Barneylyw/Bike-Aux/README.md

# Bike Auxiliary System

To power a buzzer, head lights, and tail lights with one (or more) rechargeable Li-ion battery.
 
<p align="center">bike aux</p>
Diagram 1: Rough image visualization of how the system will behave
Where the buzzer will act as a bell which will be activated by a button. The head lights and tail lights will be activated with one switch.

--Overall design Considerations--
- as small as possible
- minimize the number of re-order PCBs due to non-design related issues
- ICs should be as cheap as possible

(All blue texts are links to component datasheet)

## Project Status

| Board | Designed | Ordered | Soldered | Tested | Working | Notes |
|---|:---:|:---:|:---:|:---:|:---:|---|
| Buzzer Board | ✅ | ✅ | ✅ | ✅ | ✅ | Fully working |
| Power Dist. Board  | ✅ | ✅ | 🟡 | 🟡 | 🟡 | Oscillator unsoldered, see issues |
| Charger Board | ✅ | ✅ | ⬜ | ⬜ | ⬜ | |
| Headlight Board | ✅ | ✅ | ✅ | ✅ | ⬜ | |
| Taillight Board | ✅ | ✅ | ✅ | ✅ | ✅ | |

Legend: ✅ done · 🟡 in progress / partial · ⬜ not started

## Known Issues

| # | Board | Symptom | Hypothesis | Potential Solution |
|---|---|---|---|---|
| 1 | PDB | Vout = 2·Vin instead of 5V | Used 680µF cap instead of 680nF | uhhh, change the cap? |
| 2 | PDB (LED2000)  | LED+/LED- and all GND read ~4.6–4.7V | AGND/PWR GND isolated from circuit GND | connect AGND&PGND to ckt gnd via resistors |
| 3 | PDB (BMS) | Current doesn't drop to 0 below 2.8V UVP | Unknown — needs further probing | no clue |
| 4 | PDB (osc.) | Pin layout on SIT1534 guessed, unverified | Footprint from Ultra Librarian lacked pinout  | use a 555 timer (apperently they are not dead, there is a CMOS version) | 

### Buzzer Sub-system

Problem: My standard bike bell cannot be rung with gloves in the winter
Solution: Make a 'bell' that can be activated with a button

Buzzer used: [AI-3035-TWT-3V-R](https://puiaudio.com/file/specs-AI-3035-TWT-3V-R.pdf)
- resonance frequency (3500+-500Hz) and sound pressure level (100dB at 10cm) is similar to that of a typical bike bell
- continuous tone, more control from the user
- through hole, easier to test and solder

To achieve the desired 4000Hz, [LTC6990](https://www.analog.com/media/en/technical-documentation/data-sheets/ltc6990.pdf) is used to set the output frequency (div code = 7). The [LTC6990 online tool](https://beta-tools.analog.com/timerblox/LTC6990#) is used to help determine the value of resistance needed to set the frequency to 4kHz

The plan: First simulate the design in LTspice to ensure the resistance setting will achieve 4kHz, then design the PCB board with Altium Designer

<p align="center">6990 simulated</p>

Image 1: LTC6990 being simulated in LTspice, with the output frequency of 4kHz at a 3V output when the input is a 3VDC supply

After confirming the design will achieve 4kHz output, I used Altium Designer to design the schematic layout, then designed the PCB layout for the board

<p align="center">Buzzer Board schematic</p>

Image 2: Buzzer board schematic with the resistance value simulated in LTspice and 3V3 input and output both with B2B-XH-A 2-pin headers

<p align="center">Buzzer Board</p>

Image 3: Buzzer board PCB layout viewed from top layer with components from schematic and I/O ports labeled

--Specific Design Considerations--
- N/A

### Headlight

Headlight requirements:
- White
- greater than 600lm (similar to an off-the-sheleve part)
- <3A current to avoid overheating
According to the datasheet, [XMLBWT-00-0000-0000U3051](https://downloads.cree-led.com/files/ds/x/XLamp-XML2.pdf) (P.4) can achieve 628 lumens at 1.5A and 798 lumens at 2A (XMLBWT-00-0000-0000U4051 is brighter, but it is only sold in 1000s on Digi-Key)
Therefore, XMLBWT-00-0000-0000U3051 is chosen to be the headlights
#### Headlight Board
--Specific Design Considerations--
- heat dissipation via vias on the GND pad of the LED
- aluminum PCB to maximize heat dissipation (as I am writing this, I realized I don't need heat dissipation vias as aluminum PCBs only have 1 layer, but I already ordered it)
- GND plated through holes so that it can be connected to the bike frame
- power port
<p align="center">Front LED board</p>
Image 4: Headlight board layout with design considerations in mind

### Taillight

Taillight requirements:
- Red
- 100lm (similar to an off-the-sheleve part)

I chose [JE2835AHR-N-0001A0000-N0000001](https://downloads.cree-led.com/files/ds/j/JSeries-2835-Color.pdf), thinking it was a red light with 130lm, but I didn't notice it refers to radiant flux instead of luminous flux.
This might not work as intended with my current setup.
#### Taillight Board
--Specific Design Considerations--
- power port
- mounting holes
<p align="center">Rear LED board</p>
Image 5: Taillight board layout with a power port and mounting holes

### BMS (used in both Power Distribution Board and Charger Board)
BMS requirements:
- OVP: 4.2V
- UVP: 2.8V

[BQ297xx](https://www.ti.com/lit/ds/symlink/bq2972.pdf) family is chosen for its small BOM size and low shutdown current, I chose BQ29737 because it is the closest one that matches my requirements
following their design procedure with max load discharge current = 5A (headroom from 4A) 20mΩ is needed across both FET and V_gs=3.5, so CSD16406Q3 is likely going to work as the charging and discharging FETs

following the Typical Application from the datasheet, I created the schematic for BMS

Image 6: schematic of BMS system with BQ29737DSER as the BMS IC and CSD16406Q3 as the external charging and discharging FETs as the typical application have instructed

### Power Distribution Board
This might be the most complex system in this project... many things can (and probably will) go wrong here...
<p align="center">PDB</p>
Image 7: rough visualization of what the power distribution board consists of, blue arrows indicates power input/output ports

#### Voltage Regulator
Thr original idea is to use an LDO as it is the simplist, but since the li-ion battery doesn't have constant voltage, it can only regulate when the V_batt is high enough, so I decided to use a switching regulator

Voltage regulator requirement:
- be able to supply 5V with 4A max
I input my requirements into TI's Webench tool and it returned TPS61089 with this configuration is able to reach 5V 4A max
<p align="center">TPS61089RNRR 5V4A</p>
Image 8: how TPS61089 should be configured according to Webench

I then copied it to my schematic document in Altium
<p align="center">VR in Altium
</p>
image 9: my schematic of TPS61089 without some of the input capacitors

#### Front LED (Headlight) driver
Front LED driver requirements:
- be able to supply 2A, 3.5V(V_fled)
- easy to use
[LED2000](https://www.st.com/content/ccc/resource/technical/document/datasheet/0f/92/f3/d6/fb/2e/49/ef/DM00060040.pdf/files/DM00060040.pdf/jcr:content/translations/en.DM000600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) is able to supply 2A and 3.5V with this configuration according ST's eDesignSuite, so I copied it to my schematic document in Altium
<p align="center">Front driver config according to ST</p>
Image 10: how LED2000 should be configured according to eDesignSuite
<p align="center">Front driver in Altium</p>
image 11: my schematic of LED2000

#### 1 Hz oscillator
The original plan was to either use a 555timer or dividing a crystal signal, but then i found the [SIT1534AC-J5-DCC-00.001E](https://www.digikey.ca/en/products/detail/sitime/SIT1534AC-J5-DCC-00-001E/7793956) can produce a 1 Hz signal, so I opted for the easy solution as this is not the focus of this project and I don't need the timer to be 100% accurate, just ~1 Hz

The footprint I downloaded from Ultra Librarian doesn't specificify which pin is which while the symbol does, so I guessed the layout, so it might not work as intended(i.e. the taillight won't blink)

I have since realized that it is a crystal oscillator, which is an absolute overkill. I might go for the 555timer solution since I still don't know what the pin layout is

#### Rear LED (taillight) driver
Rear LED driver requirements:
- able to supply >250mA
- consist of an enable pin
- 5V input
- easy to use

I was debating between [NCP3066](https://mm.digikey.com/Volume0/opasdata/d220001/medias/docus/1149/NCP%2CNCV3066.pdf) and [Pam2804](https://www.diodes.com/assets/Datasheets/PAM2804.pdf)
<table>
  <tr>
    <th></th>
    <th>NCP3066</th>
    <th>PAM2804</th>
  </tr>
  <tr>
    <td>Max current supply</td>
    <td>1.5A</td>
    <td>1A</td>
  </tr>
  <tr>
    <td>External parts</td>
    <td>7</td>
    <td>4</td>
  </tr>
  <tr>
    <td>Input voltage</td>
    <td>0-42V</td>
    <td>2.5-6V</td>
  </tr>  
  <tr>
   <td>How to determine components</td>
   <td>9 equations</td>
   <td>I_led = 0.1/Rs</td>
  </tr>
</table>
Table 1: a table I made for myself to compare which one is the better option, both matches the requirements, but PAM2804 is easier to use, therefore PAM2804 is chosen as the rear led driver

To determine Rs, I used the provided equation : I_led = 0.25A = 0.1/Rs -> 0.4Ω and created the schematic accordingly
<p align="center">Rear LED driver in Altium</p>
Image 12: schematic of the rear led driver with R9 = 0.4Ω to set the I_led = 0.25A

#### Board layout
requirements for TPS61089:
- Minimize length and area connected to SW pin
- Capacitors should be as close to their respectful pins as possible
- Vout path should be as short as possible
- Current carrying paths should be wider
requirements for LED2000:
- FB connections be far from high current paths
- FB -> R_sense path be as short as possible
- 2 GND plans connected at Cout (C6 in my schematic)
-  - Signal GND: AGND(Pin6), R3, C7
   - PWR GND: Cout(C6), Cin(C3), GND(Pin7), PWR GND(Pin2)
Personal requirements:
- section by section so that it's easier to separate parts
- test points (at Vin,Vout,CLK_out,I_fled,I_rled)
- raw 3.7V input port for testing
- smaller than 10cm x 5cm

to determine the trace width, I used the [digikey trace width calculator](https://www.digikey.ca/en/resources/conversion-calculators/conversion-calculator-pcb-trace-width) to determine the width at different traces while assuming 10C rise:
<table style="width:100%; border-collapse: collapse; border: 1px solid #ddd;">
  <tr style="background-color: #2196F3; color: white;">
    <th style="border: 1px solid #ddd; padding: 12px;">Input Current (A)</th>
    <th style="border: 1px solid #ddd; padding: 12px;">External Trace Width (mm)</th>
  </tr>
  <tr>
    <td style="border: 1px solid #ddd; padding: 12px;">6</td>
    <td style="border: 1px solid #ddd; padding: 12px;">3.55</td>
  </tr>
  <tr style="background-color: #f9f9f9;">
    <td style="border: 1px solid #ddd; padding: 12px;">4</td>
    <td style="border: 1px solid #ddd; padding: 12px;">2.03</td>
  </tr>
  <tr>
    <td style="border: 1px solid #ddd; padding: 12px;">2</td>
    <td style="border: 1px solid #ddd; padding: 12px;">0.78</td>
  </tr>
  <tr style="background-color: #f9f9f9;">
    <td style="border: 1px solid #ddd; padding: 12px;">0.25</td>
    <td style="border: 1px solid #ddd; padding: 12px;">0.0444</td>
  </tr>
</table>
table 2: how wide should the trace be depending on the current with temperature rise = 10C, only external width matter since I am only designing a 2 layer PCB
<p align="center">PDB</p>
image 13: final design of the PDB with all the design requirements followed as closely as possible. includes 1 input port, 3 output port, 1 test input port, mounting holes, and words to indicate what is what.

Since the LED 2000 requires an AGND and PWG GND, but I don't know how they should be connected to the rest of the grounds, I separated them from circuit ground, which might be a bad design decision...

### Charger Board
Charger board requirements:
- charger IC
- BMS, as backup to stop charging (reuse the same system as before)
- power input port
Charger IC requirements:
- 4.2V cutoff
- simple to use
- >=500mA charge current
- protection agains't charging from cold
- easy to add indicator/built in capabilities for them
[BQ24040](https://www.ti.com/lit/ds/symlink/bq24040.pdf) is the smartest with the most protection out of my options of [Sl4056E](https://mm.digikey.com/Volume0/opasdata/d220001/medias/docus/8922/5399_SL4056E%20ESOP-8.pdf) and [MCP73811](https://ww1.microchip.com/downloads/aemDocuments/documents/OTH/ProductDocuments/DataSheets/22036b.pdf) and it also have `charging`  and `power good` indicators.

I_charge is usually 0.2-0.5C (C = capacity of Li-ion battery)
I_charge = 1A in my case

I used the [BQ24040 Application Report](https://www.ti.com/lit/an/slua901/slua901.pdf?ts=1787425354239) as my guide to 1A fast charge design except with %_IOutFC = 10% = 100mA
following the design procedure outlined:
I_out-FC = 1A
%_I-Out-FC=10%
R_ISet = 540AΩ/1000mA = 540Ω (549Ω is the closest most abundantly available resistor)
R_Pre-term = 200Ω/% * 1-% = 2kΩ

I decided to use the C_out pin from BMS for a `complete charge` indicator alongside a FET and power from Vin

knowing C_out will be pulled to 0.4-0.5V when full charge and V_in = 5V, V_gs = ~-4.5V, V_gs(th) from [Bss84AK](https://assets.nexperia.com/documents/data-sheet/BSS84AK.pdf) is - 1.6V > -4.5V, so it would work in theory. I also recreated the circuit in LTspice to verify that it works.

<p align="center">Charge indicator in LTspice</p>
image 14: full charge indicator verification in LTspice, showing the current leaving R2 = -1mA at 3.4V and -20mA at 0.4V, so it should work

I then put everything into the schematic
<p align="center">Charger schematic</p>
Image 15: charger schematic, showing both BQ24040, BQ29737, BSS84AK, and dual input options, barrel jack and USB micro

<p align="center">Charger layout</p>
Image 16: charger board layout with the LEDs being all over the place 😅

### PCB and parts
They are ordered from JLCPCB, Digikey, and Mouser; what I ordered can be found in the `orders` folder

## Assembly and testing

This section covers how I assemble and test different boards

Note: I am documenting my testing day of (or a few days) after I conducted the tests, so from here on it will be more of a log than anything. I apologize for the causal wording.

### Buzzer Board
I spread the solder paste onto the board and placed the parts where they are supposed to go according to the design, and used hot-air reflow to solder everything in place.

<p align="center">boards out of factory</p>
Image 17: unassembled buzzer boards

<p align="center">assembled buzzer board</p>
Image 18: buzzer board after I soldered the components and pins on it

To test the functionality of the board, I used Analog Discovery 2's (AD2) `scope` and `source` functions to input 5V (output from the power distribution) and see if the output is 4kHz with the following connections:

V+ -> input

1+ -> output

GND -> GND

<p align="center">testing CKT</p>
Image 19: how the board is tested with AD2, showing all connections in and out of the board

With this setup, the board can reach the desired frequency of 4kHz 

<p align="center">Oscillator LTC4990 test</p>
Image 20: test results in AD2's software, waveform, showing input = 5V (Ch1), oscillilating output at 4kHz (Ch2)

Knowing the oscillator can reach 4kHz, I proceeded to connect the output to the buzzer to test if it is compatible with the buzzer. The buzzer made a loud, high-pitched noise that annoyed me, so I know it works

I then connected the button in the middle to test the full buzzer system to see if it activates with a press of a button

https://github.com/user-attachments/assets/9203218f-8cd7-4593-b8c7-8493a15fe9b1

Video 1: me testing the buzzer system, showing the buzzer turns on when the button is pressed; the buzzer is facing down as it won't be as loud

### Power Distribution Board
Since there are many subsystems in the power distribution board, I decided to solder and test the board subsystem by subsystem, starting with the voltage regulator

I have completed soldering the board except for the crystal oscillator since it is too hard to put solder paste on; I will need to redesign that part of the board in the future

#### Voltage Regulator
Soldered the voltage regulator and its related components onto the board

I used the AD2's `supply` function to supply a constant voltage from 2.7V to 4.2V, but somehow V_out = 2V_in - (something) instead of 5V, not sure what is wrong. Despite this, since if Vin = 2.7V, V_out = ~5V, I will use that to test the rest of the subsystems.

I realized I used a 680uF capacitor instead of a 680nF capacitor, so that might be the issue

#### Front LED driver

I first checked the polarities on the LED, then connected it to the board

Nothing is working, so I multi-metered and used the `scope` in AD2 for the pins on the LED2000 and found:
- LED+ and LED- pins are both outputting ~4.7V
- all the grounds (AGND & PWG GND) are ~4.6V
which leads me to think it's because my grounds are not connected to circuit ground because I didn't know what to do with the grounds, so I separated them from circuit ground

#### Rear LED driver
Since the oscillator isn't connected, I manually used a jumper wire to connect 5V to the EN pin to enable the driver

I then made sure the LED polarities are correct and connected the LED to the respective pins and turned on the power supply from AD2, LED lit up, it works! :)

https://github.com/user-attachments/assets/d2f4da75-583c-456d-983e-1b7f2b622fab

Video 2: testing the rear led, it lights up after I turn on the power from AD2 

### Buzzer subsystem

Button and buzzer holder to hold the components

I printed V1 of both brackets, and their holes are too big to be held tightly on the bike as shown in the pictures below

<table>
 <tr>
  <td>buzzer holder</td>
  <td>button holder</td>
 </tr>
</table>

 image 21,22: holders with too big of a hole for the bike frame

### BMS circuit testing
Oct 19 start
Since I used the same BMS circuit for my power distribution and charger board, I am only testing the circuit on the PD board

The plan: 
1. Use AD2 as my 'battery' (so that I don't blow up my actual Li-ion battery and have my landlord on my rear end)
2. Use the ammeter to connect Pack+ and GND with a series resistor (10Ω) to see if the current is conducting
3. Change the voltage input setting on AD2 from <2.8V-4.2V and see if it shuts off (no ammeter reading) when it's lower than 2.8V

I tested the circuit according to my plan, but it was only conducting ~4 mA, which does not make sense with Vin = ~3.5 V and a 10Ω resistor (should be getting ~280 mA)

I realized my GND on the PCB isn't the same GND as the 'battery' (AD2), so after I connected PCB GND to AD2 GND, I got a reading of ~270 mA when Vin = 3.7 V

However, when I decrease the voltage down to <2.8 V, the current kept decreasing almost linearly instead of becoming an open circuit and current = 0mA. I have no idea what is going on; I am calling it a day for now (Oct 19 end)

Oct 21 start
Barely any time to work on it today

I decided to test the Drain pin that is common with the FET that is connected to C_out. However, I don't have a test point there, so I scraped off the solder mask to test the drain pin.

Verified D_out goes low when V_Batt+ < 2.8V, so the IC is working :)

(end of Oct 21)

Oct 23 start
New evening, new brain

Decided to check the FET.  V_drain = 1.1V when V_Batt+ = 2.5V

I then tried to test continuity between source (Batt-) and drain (PCB GND) with an ammeter;  it reads ~9 µA @ V_Batt+ = 2.5V (good news?) but = -0.3 μA @ V_Batt+ = 3.5 V (basically nothing... not good...)

Here is the question: does V_drain being at a different voltage than V_batt- prove its discontinuity, and why is I_SD -0.3 μA @ V_Batt+ = 3.5 V? 

Maybe my new evening brain isn't working that well... (end of Oct 23)

Oct 26

Answer to my previous question: No, it can just be a resistance; no clue why I_SD is so low.

I made an LTspice simulation around the FET just to make sure I'm not going crazy, and then I probed PCB GND and measured the current from a dummy load (100Ω)

BMS FET testingr

From the simulation, I know what I'm supposed to get, but I don't think I'm getting any of the expected results

I'll call this unsuccessful and have to redesign (at least add more test points)

## Mechanical integration
To 3D print mounting brackets with a single/two-piece split clamp design and board holders for the different components

### Current status
Parts have arrived; I am currently assembling and testing them while designing a mechanical integration system

# Changes for V2
many

school is getting busy, ssslllooowww progress
