Barneylyw/Bike-Aux/orders/bike aux mouser parts.xls

SHOPPING CART
This is not an invoice
27-Aug-26 20:49:04
 | Mouser # | Mfr. # | Manufacturer | Customer # | Description | RoHS | Lifecycle | Order Qty. | Price (CAD) | Ext.: (CAD)
1 | 941-XMLBWT0000U3051 | XMLBWT-00-0000-0000U3051 | Cree LED |  | White LEDs White 6200 K 65-CRI, XLamp XMLBWT | RoHS Compliant | NRND | 1 | $6.74 | $6.74
2 | 485-3221 | 3221 | Adafruit |  | Adafruit Accessories Mini Panel Mount SPDT Toggle Switch |  |  | 2 | $1.37 | $2.74
3 | 80-C0402C103K5REAULR | C0402C103K5RECAUTO7411 | KEMET |  | Multilayer Ceramic Capacitors MLCC - SMD/SMT 50V 0.01uF X7R 0402 10% AEC-Q200 | RoHS Compliant |  | 10 | $0.118 | $1.18
4 | 71-CRCW0402-316K-E3 | CRCW0402316KFKED | Vishay |  | Thick Film Resistors - SMD 1/10 Watt 316Kohms 1% | RoHS Compliant By Exemption |  | 10 | $0.029 | $0.29
5 | 665-AI3035TWT3VR | AI-3035-TWT-3V-R | PUI Audio |  | Buzzers & Audio Indicators - Board Mount 3VDC 9MA 100DBA 3500HZ | RoHS Compliant |  | 1 | $6.18 | $6.18
6 | 603-RC0402FR-07100KL | RC0402FR-07100KL | YAGEO |  | Thick Film Resistors - SMD General Purpose Chip Resistor 0402, 100kOhms, 1%, 1/16W | RoHS Compliant By Exemption |  | 10 | $0.016 | $0.16
7 | 511-LED2000DR | LED2000DR | STMicroelectronics |  | Current & Power Monitors & Regulators 3A monolithic Conv 850kHz Synch | RoHS Compliant |  | 5 | $3.43 | $17.15
8 | 187-CL05A105KO5NNNC | CL05A105KO5NNNC | Samsung Electro-Mechanics |  | Multilayer Ceramic Capacitors MLCC - SMD/SMT 1uF+/-10% 16V X5R 10 0402 | RoHS Compliant |  | 20 | $0.124 | $2.48
9 | 71-CRCW0402-309K-E3 | CRCW0402309KFKED | Vishay |  | Thick Film Resistors - SMD 1/10 Watt 309Kohms 1% | RoHS Compliant By Exemption |  | 10 | $0.029 | $0.29
10 | 81-GRM1555C1H821JA1D | GRM1555C1H821JA01D | Murata |  | Multilayer Ceramic Capacitors MLCC - SMD/SMT 820 pF 50 VDC 5% 0402 C0G (NP0) | RoHS Compliant |  | 10 | $0.036 | $0.36
11 | 810-CGA4J1X7S1C685KC | CGA4J1X7S1C685K125AC | TDK |  | Multilayer Ceramic Capacitors MLCC - SMD/SMT CGA 0805 16V 6.8uF X7S 10% AEC-Q200 | RoHS Compliant |  | 5 | $0.662 | $3.31
12 | 603-RT0402FRE07107KL | RT0402FRE07107KL | YAGEO |  | Thin Film Resistors - SMD 1/16W 107K ohm 1% 50ppm | RoHS Compliant By Exemption |  | 10 | $0.017 | $0.17
13 | 603-RC0402FR-07240KL | RC0402FR-07240KL | YAGEO |  | Thick Film Resistors - SMD General Purpose Chip Resistor 0402, 240kOhms, 1%, 1/16W | RoHS Compliant By Exemption |  | 10 | $0.013 | $0.13
14 | 667-ERJ-2RKF7682X | ERJ-2RKF7682X | Panasonic |  | Thick Film Resistors - SMD 0402 76.8Kohms 1% AEC-Q200 | RoHS Compliant By Exemption |  | 10 | $0.029 | $0.29
15 | 187-CL31A107MQHNNWE | CL31A107MQHNNWE | Samsung Electro-Mechanics |  | Multilayer Ceramic Capacitors MLCC - SMD/SMT 100uF+/-20% 6.3V X5R 1206 | RoHS Compliant |  | 5 | $0.864 | $4.32
16 | 621-PAM2804AAB010 | PAM2804AAB010 | Diodes Incorporated |  | LED Lighting Driver ICs 1A SD CONSTANT CRNT HI EFF LED DVR | RoHS Compliant |  | 5 | $0.763 | $3.82
17 | 603-RL0603FR070R4L | RL0603FR-070R4L | YAGEO |  | Current Sense Resistors - SMD 400 mOhms 100mW 1 % 800 ppm/C | RoHS Compliant By Exemption |  | 10 | $0.171 | $1.71
18 | 603-RT0603BRC07500RL | RT0603BRC07500RL | YAGEO |  | Thin Film Resistors - SMD 500 ohm 0.1% 15ppm H igh Stability | RoHS Compliant By Exemption |  | 5 | $0.36 | $1.80
19 | 603-PE0603DRF570R04L | PE0603DRF570R04L | YAGEO |  | Current Sense Resistors - SMD 40 mOhms 100ppm 0603 .5% AEC-Q200 | RoHS Compliant |  | 5 | $0.518 | $2.59
20 | 187-CL10A475KQ8NNWC | CL10A475KQ8NNWC | Samsung Electro-Mechanics |  | Multilayer Ceramic Capacitors MLCC - SMD/SMT 4.7uF+/-10% 6.3V X5R 0603 | RoHS Compliant |  | 10 | $0.042 | $0.42
21 | 187-CL05B104KP5VPNC | CL05B104KP5VPNC | Samsung Electro-Mechanics |  | Multilayer Ceramic Capacitors MLCC - SMD/SMT 0402 X7R 100000pF 10% 10V automotive grade | RoHS Compliant |  | 30 | $0.039 | $1.17
22 | 963-TMK107ABJ225KA-T | TMK107ABJ225KA-T | TAIYO YUDEN |  | Multilayer Ceramic Capacitors MLCC - SMD/SMT PLEASE SEE SUGGESTED ALTERNATE MSAST168AB5225KTNA01 | RoHS Compliant |  | 10 | $0.082 | $0.82
23 | 737-SWPB11DZAP1A | SW-PB1-1DZ-A-P1-A | Adam Tech |  | Pushbutton Switches - Industrial SPST, ON-OFF, 3A, 250V Pushbutton Switch | RoHS Compliant |  | 2 | $0.648 | $1.30
24 | 595-TPS61089RNRR | TPS61089RNRR | Texas Instruments |  | Switching Voltage Regulators 12.6-V 7-A Fully-In tegrated Synchronous A 595-TPS61089RNRT | RoHS Compliant |  | 5 | $3.95 | $19.75
25 | 595-BQ29737DSER | BQ29737DSER | Texas Instruments |  | Battery Management Lithium-ion / lithiu m-polymer advanced BQ29737DSET | RoHS Compliant |  | 10 | $0.58 | $5.80
26 | 595-CSD16406Q3 | CSD16406Q3 | Texas Instruments |  | MOSFETs N-Ch NexFET Power MO SFETs | RoHS Compliant By Exemption |  | 10 | $1.38 | $13.80
27 | 708-RMCF0402FT2K20 | RMCF0402FT2K20 | SEI Stackpole |  | Thick Film Resistors - SMD 2.2KOhms 0402 0.0625W 1% Std Power AEC-Q200 | RoHS Compliant By Exemption |  | 10 | $0.017 | $0.17
28 | 603-RC0402FR-07330RL | RC0402FR-07330RL | YAGEO |  | Thick Film Resistors - SMD General Purpose Chip Resistor 0402, 330Ohms, 1%, 1/16W | RoHS Compliant By Exemption |  | 10 | $0.013 | $0.13
29 | 603-RC0402FR-0710KL | RC0402FR-0710KL | YAGEO |  | Thick Film Resistors - SMD General Purpose Chip Resistor 0402, 10kOhms, 1%, 1/16W | RoHS Compliant By Exemption |  | 10 | $0.013 | $0.13
30 | 603-RC0402FR-0797K6L | RC0402FR-0797K6L | YAGEO |  | Thick Film Resistors - SMD General Purpose Chip Resistor 0402, 97.6kOhms, 1%, 1/16W | RoHS Compliant By Exemption |  | 10 | $0.013 | $0.13
31 | 71-CRCW0402-8.87K-E3 | CRCW04028K87FKED | Vishay |  | Thick Film Resistors - SMD 1/10 Watt 8.87Kohms 1% 100ppm | RoHS Compliant By Exemption |  | 10 | $0.029 | $0.29
32 | 603-RC0402FR-07549RL | RC0402FR-07549RL | YAGEO |  | Thick Film Resistors - SMD General Purpose Chip Resistor 0402, 549Ohms, 1%, 1/16W | RoHS Compliant By Exemption |  | 10 | $0.013 | $0.13
33 | 603-RC0402FR-072KL | RC0402FR-072KL | YAGEO |  | Thick Film Resistors - SMD General Purpose Chip Resistor 0402, 2kOhms, 1%, 1/16W | RoHS Compliant By Exemption |  | 10 | $0.016 | $0.16
34 | 603-RC0402FR-071K5L | RC0402FR-071K5L | YAGEO |  | Thick Film Resistors - SMD General Purpose Chip Resistor 0402, 1.5kOhms, 1%, 1/16W | RoHS Compliant By Exemption |  | 10 | $0.013 | $0.13
35 | 306-B3BXHALFSNP | B3B-XH-A(LF)(SN) | JST |  | Headers & Wire Housings XH HEADER (TOP) | RoHS Compliant |  | 10 | $0.156 | $1.56
36 | 603-RT0402BRD07200RL | RT0402BRD07200RL | YAGEO |  | Thin Film Resistors - SMD 1/16W 200 ohm .1% 25ppm | RoHS Compliant By Exemption |  | 10 | $0.099 | $0.99
By submitting your order you agree to these terms and conditions. (https://www.mouser.ca/saleterms) |  |  |  |  |  |  |  |  | Merchandise: | $102.59
Prices are reflected at the date and time shown. |  |  |  |  |  |  |  |  | Shipping Charge: | $0.00
