Barneylyw/Bike-Aux/Full charge indicator.asc

R2: res; 250
U1: BSS84AK
V3: voltage; 0.2
V4: voltage; 5
Named nets: 0
.dc V3 0 4.5
battery
