Barneylyw/Bike-Aux/Buzzer.asc

C1: cap; 100n
C2: cap; 18000p
R1: res; 97.6k
R2: res; 10k
R3: res; 8.87k
U1: LTC6990
V1: voltage; 3
Named nets: 0
.tran 5ms
.lib XPGDWT_S.txt
.lib XPLBWT.txt
