Barneylyw/Bike-Aux/(list of files, drawings)

Other design files:
Buzzer Board.PrjPcb
Charger.PrjPcb
Front LED.PrjPcb
Power Distribution.PrjPcb
Rear LED.PrjPcb
